Floppie209/Amiga2000-remake/Amiga2000rev6.2.incl.mods.1.8.5.BOM.txt

Partlist from file: Amiga2000rev6.2.incl.mods.1.8.lay6" / 10-11-2019 15:54:42

No	Name	Value			Layer	Comment

1	1				Top	Skull logo
2	201	5mm			Top	Double Ferrite Bead
3	206	100pf			Top	
4	207	100pf			Top	
5	210	100pf			Top	
6	211	100pf			Top	
7	216	5mm			Top	Double Ferrite Bead
8	217	5mm			Top	Double Ferrite Bead
9	218	5mm			Top	Double Ferrite Bead
10	219	5mm			Top	Double Ferrite Bead
11	220	5mm			Top	Double Ferrite Bead
12	221	5mm			Top	Double Ferrite Bead
13	900	5mm			Top	Double Ferrite Bead
14	901	5mm			Top	Double Ferrite Bead
15	902	5mm			Top	Double Ferrite Bead
16	903	5mm			Top	Double Ferrite Bead
17	Hole	3,8 mm			Top	Mounting Hole
18	Hole	3,8 mm			Top	Mounting Hole
19	Hole	3,8 mm			Top	Mounting Hole
20	Hole	3,8 mm			Top	Mounting Hole
21	Hole	3,8 mm			Top	Mounting Hole
22	Hole	3,8 mm			Top	Mounting Hole
23	Hole	3,8 mm			Top	Mounting Hole
24	Hole	3,8 mm			Top	Mounting Hole
25	Hole	3,5 mm			Top	Mounting Hole
26	BT800	3V Battery		Top	Buttoncell Battery
27	C100	0,1uf			Top	
28	C101	0,1uf			Top	
29	C102	0,1uf			Top	
30	C103	0,1uf			Top	
31	C104	0,1uf			Top	
32	C105	0,1uf			Top	
33	C106	0,1uf			Top	
34	C107	0,1uf			Top	
35	C108	0,1uf			Top	
36	C110	0,1uf			Top	
37	C200	0,1uf			Top	
38	C201	0,22uf			Top	
39	C202	0,1uf			Top	
40	C203	0,1uf			Top	
41	C204	0,01uf			Top	
42	C205	0,1uf			Top	
43	C206	0,1uf			Top	
44	C210	0,047uf			Top	
45	C211	0,047uf			Top	
46	C212	0,047uf			Top	
47	C213	0,047uf			Top	
48	C214	470uf 16/25v		Top	
49	C215	0,22uf			Top	
50	C216	0,22uf			Top	
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
449	R402	68R			Top	0805
450	R403	500R			Top	0805
451	R500	4k7			Top	
452	R601	1k			Top	
453	R602	1k			Top	
454	R603	1k			Top	
455	R604	1k			Top	
456	R605	1k			Top	
457	R800	1k			Top	
458	R801	470R			Top	
459	R802	10k			Top	
460	R803	470R			Top	
461	R804	10k			Top	
462	R805	47k			Top	
463	R806	4k7			Top	
464	R807	4k7			Top	
465	R900	1k			Top	
466	R901	Empty			Top	Not Populated
467	R902	4k7			Top	
468	R904	47R			Top	
469	R905	47R			Top	
470	R914	1R 0,5w			Top	0,5 Watt
471	R916	4k7			Top	
472	R917	330R			Top	
473	R1000	330R			Top	
474	R407-C307	68R + 270pf	Top	
475	RP100	4k7			Top	SIP 10
476	RP101	4k7			Top	SIP 10
477	RP102	47R			Top	Isolated Pack 4Res SIP 8
478	RP200	4k7			Top	SIP 10
479	RP201	47R			Top	Isolated Pack 4Res SIP 8
480	RP203	47R			Top	Isolated Pack 4Res SIP 8
481	RP204	68R			Top	Isolated Pack 4Res SIP 8
482	RP205	1k			Top	SIP 6
483	RP300	10k			Top	SIP 10
484	RP301	1k			Top	SIP 6
485	RP500	47R			Top	Isolated Pack 5Res SIP 10
486	RP501	47R			Top	Isolated Pack 5Res SIP 10
487	RP502	22R			Top	Isolated Pack 5Res SIP 10
488	RP503	470R			Top	SIP 10
489	RP600	10k			Top	SIP 8
490	RP601	1K			Top	SIP 10
491	RP602	1K			Top	SIP 10
492	RP603	1K			Top	SIP 10
493	RP604	470R			Top	SIP 10
494	RP605	1K			Top	SIP 10
495	RP607	1k			Top	SIP 6
496	RP700	1K			Top	SIP 10
497	RP701	1K			Top	SIP 10
498	RP702	1K			Top	SIP 10
499	RP703	1K			Top	SIP 10
500	RP704	1K			Top	SIP 10
501	RP705	4k7			Top	SIP 10
502	RP800	1k			Top	SIP 8
503	RP801	4k7			Top	SIP 8
504	RP802	1k			Top	Isolated pack 5res SIP 10
505	RP900	Empty			Top	Not Populated
506	RP901	Empty			Top	Not Populated
507	RP902	47R			Top	Isolated Pack 4Res SIP 8
508	RP903	1k			Top	SIP 6
509	RP904	Empty			Top	Not Pupulated
510	RP905	Empty			Top	Not Populated
511	RP906	Empty			Top	Not Populated
512	RP907	47R			Top	Isolated Pack 4Res SIP 8
513	RP908	1k			Top	SIP 6
514	RP603-1	3k3			Top	SIP 10
515	RP604-1	3k3			Top	SIP 10
516	U100	MC68000			Top	Processor
517	U101	AGNUS 8372		Top	Fat Lady (Agnus)
518	U102	GARY			Top	Gary
519	U103	SN74F245N		Top	
520	U104	SN74LS373N		Top	
521	U105	SN74F245N		Top	
522	U106	SN74LS373N		Top	
523	U107	SN74F04N		Top	
524	U108	SN74LS74AN		Top	
525	U200	PAULA			Top	Paula
526	U201	DENISE			Top	Denise
527	U202	SN74LS157N		Top	
528	U203	SN74LS38N		Top	
529	U204	LF347N/NOPB		Top	
530	U205	SN74LS244N		Top	
531	U206	SN74LS244N		Top	
532	U300	CIA 8520		Top	Odd CIA
533	U301	CIA 8520		Top	Even CIA
534	U302	SN74LS32N		Top	
535	U303	SN74F08N		Top	
536	U304	MC1488N			Top	
537	U305	MC1489N			Top	
538	U500	27C400			Top	Kickstart Chip
539	U501	4256-10			Top	Memory chip
540	U502	4256-10			Top	Memory chip
541	U503	4256-10			Top	Memory chip
542	U504	4256-10			Top	Memory chip
543	U505	4256-10			Top	Memory chip
544	U506	4256-10			Top	Memory chip
545	U507	4256-10			Top	Memory chip
546	U508	4256-10			Top	Memory chip
547	U540	SN74F244N		Top	
548	U541	SN74F244N		Top	
549	U600	SN74LS245N		Top	
550	U601	SN74LS245N		Top	
551	U602	SN74ALS245AN		Top	
552	U603	SN74LS245N		Top	
553	U604	SN74LS245N		Top	
554	U605	SN74ALS245AN		Top	
555	U606	SN74LS32N		Top	
556	U607	SN74LS08N		Top	
557	U800	BUSTER 5721		Top	Buster
558	U801	MSM6242			Top	
559	U802	SN74LS138N		Top	
560	U803	SN74LS08N		Top	
561	U804	SN74LS148N		Top	
562	U805	LM339			Top	
563	U900	SN74F00N		Top	
564	VC800	22-47pF			Top	
565	X1	28.37516MHz Oscillator	Top	Dip14
566	Y800	32768Hz			Top
