Floppie209/Amiga2000-remake/Amiga2000rev6.2.incl.mods.rev-1.8.5-Bestelliste.xlsx

No | Name | Value | Layer | Comment | Mouser | Digikey | Reichelt | Conrad | Ebay | Nr Required
1 | 1 |  | Top | Skull logo | x | x | x | x | x
2 | 201 | 5mm | Top | Double Ferrite Bead | 81-BL03RN2R1P1A |  |  |  |  | 11
3 | 216 | 5mm | Top | Double Ferrite Bead | 81-BL03RN2R1P1A
4 | 217 | 5mm | Top | Double Ferrite Bead | 81-BL03RN2R1P1A
5 | 218 | 5mm | Top | Double Ferrite Bead | 81-BL03RN2R1P1A
6 | 219 | 5mm | Top | Double Ferrite Bead | 81-BL03RN2R1P1A
7 | 220 | 5mm | Top | Double Ferrite Bead | 81-BL03RN2R1P1A
8 | 221 | 5mm | Top | Double Ferrite Bead | 81-BL03RN2R1P1A
9 | 900 | 5mm | Top | Double Ferrite Bead | 81-BL03RN2R1P1A
10 | 901 | 5mm | Top | Double Ferrite Bead | 81-BL03RN2R1P1A
11 | 902 | 5mm | Top | Double Ferrite Bead | 81-BL03RN2R1P1A
12 | 903 | 5mm | Top | Double Ferrite Bead | 81-BL03RN2R1P1A
13 | Hole | 3,8 mm | Top | Mounting Hole | x | x | x | x | x
14 | Hole | 3,8 mm | Top | Mounting Hole | x | x | x | x | x
15 | Hole | 3,8 mm | Top | Mounting Hole | x | x | x | x | x
16 | Hole | 3,8 mm | Top | Mounting Hole | x | x | x | x | x
17 | Hole | 3,8 mm | Top | Mounting Hole | x | x | x | x | x
18 | Hole | 3,8 mm | Top | Mounting Hole | x | x | x | x | x
19 | Hole | 3,8 mm | Top | Mounting Hole | x | x | x | x | x
20 | Hole | 3,8 mm | Top | Mounting Hole | x | x | x | x | x
21 | Hole | 3,5 mm | Top | Mounting Hole | x | x | x | x | x
22 | BT800 | 3V Battery | Top | Buttoncell Battery |  |  |  |  |  | 1
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
225 | C791 | 1000pf | Top |  | 581-SA105C102KAR
226 | C793 | 1000pf | Top |  | 581-SA105C102KAR
227 | C794 | 1000pf | Top |  | 581-SA105C102KAR
228 | C796 | 1000pf | Top |  | 581-SA105C102KAR
229 | C800 | 0,1uf | Top |  | 581-SA105C104KARC
230 | C802 | 0,1uf | Top |  | 581-SA105C104KARC
231 | C803 | 0,1uf | Top |  | 581-SA105C104KARC
232 | C804 | 0,1uf | Top |  | 581-SA105C104KARC
233 | C805 | 0,1uf | Top |  | 581-SA105C104KARC
234 | C810 | 20pf | Top |  | 581-SA102A200JAR |  |  |  |  | 1
235 | C811 | 4,7uf 16v | Top |  | 647-UMA1C4R7MCD2TP
236 | C812 | 0,1uf | Top |  | 581-SA105C104KARC
237 | C813 | 22uf 16v | Top |  | 667-ECA-1CM220B
238 | C814 | 22uf 16v | Top |  | 667-ECA-1CM220B
239 | C815 | 0,1uf | Top |  | 581-SA105C104KARC
240 | C900 | 0,1uf | Top |  | 581-SA105C104KARC
241 | C901 | 0,1uf | Top |  | 581-SA105C104KARC
242 | C902 | Empty | Top | Not Populated | *
243 | C903 | 0,1uf | Top |  | 581-SA105C104KARC
244 | C904 | 100pf | Top |  | 80-C410C101K5G
245 | C905 | 100pf | Top |  | 80-C410C101K5G
246 | C906 | 0,1uf | Top |  | 581-SA105C104KARC
247 | C907 | 100pf | Top |  | 80-C410C101K5G
248 | C908 | 100pf | Top |  | 80-C410C101K5G
249 | C909 | Empty | Top | Not Populated | *
250 | C910 | 0,1uf | Top |  | 581-SA105C104KARC
251 | C912 | 470uf 16/25v | Top |  | 647-UVR1E471MPD
252 | C913 | 47pf | Top |  | 80-C410C470K1G |  |  |  |  | 1
253 | C914 | 100pf | Top |  | 80-C410C101K5G
254 | C915 | 0,1uf | Top |  | 581-SA105C104KARC
255 | C916 | 0,1uf | Top |  | 581-SA105C104KARC
256 | C917 | Empty | Top | Not Populated | *
257 | C918 | 0,1uf | Top |  | 581-SA105C104KARC
258 | C919 | 0,1uf | Top |  | 581-SA105C104KARC
259 | C920 | 100pf | Top |  | 80-C410C101K5G
260 | CN200 | 9pin male | Top | 9 PIN MALE |  |  |  | 625-357-09 |  | 2
261 | CN201 | 9pin male | Top | 9 PIN MALE |  |  |  | 652-357-09
262 | CN202 | 23pin male | Top | 23 PIN MALE |  |  |  |  |  | iComp 1
263 | CN203 | 36pin, (2x18, .100) | Top | INTERNAL VIDEO SLOT TOP | 571-5530843-3 | A31716-ND
264 | CN204 | Audio | Top | Right Audio |  |  | LUM 1553 02 WS |  | ebay | 1
265 | CN205 | Audio | Top | Left Audio |  |  | LUM 1553 02 RT |  | ebay | 1
266 | CN206 | Video B/W | Top | Composite video |  |  | LUM 1553 02 GB |  | ebay | 1
267 | CN207 | 36pin, (2x18, .100) | Top | INTERNAL VIDEO SLOT BOTTOM | 571-5530843-3 | A31716-ND
268 | CN300 | 5pin Din | Top | KEYBOARD |  |  | MABPM 5S | 613-647-14 |  | 1
269 | CN301 | 25pin female | Top | 25 PIN FEMALE |  |  |  | 635-518-05 |  | 1
270 | CN302 | 23pin female | Top | 23 PIN FEMALE |  |  |  |  |  | iComp 1
271 | CN303 | 2x17 | Top | PINHEADER 2X17
272 | CN304 | 2x13 | Top | PINHEADER 2X13
273 | CN305 | 25pin male | Top | 25 PIN MALE |  |  |  | 616-442-12 |  | 1
274 | CN306 | 1x03 | Top | PINHEADER 1X03
 | CN400 | 14pin male | Top | 14 PIN MALE | 538-26-60-4140 |  |  |  |  | 1
275 | CN600 | 86pin (2x43, .100) | Top | CO PROCESSOR SLOT | 571-1-5530843-0 | A144213-ND |  |  |  | 1
276 | CN601 | 100pin, (2x50, .100) | Top | ZORRO II SLOT | 571-5645235-3 | A121376-ND |  |  |  | 5
277 | CN602 | 100pin, (2x50, .100) | Top | ZORRO II SLOT | 571-5645235-3 | A121376-ND
278 | CN603 | 100pin, (2x50, .100) | Top | ZORRO II SLOT | 571-5645235-3 | A121376-ND
279 | CN604 | 100pin, (2x50, .100) | Top | ZORRO II SLOT | 571-5645235-3 | A121376-ND
280 | CN605 | 100pin (2x50, .100) | Top | ZORRO II SLOT | 571-5645235-3 | A121376-ND
281 | CN606 | 1x04 | Top | PINHEADER 1X04
282 | CN700 | 62pin, (2x31, .100) | Top | IBM 8BIT EXPANSION BUS | 571-7-5530843-0 | A121053-ND |  |  |  | 4
283 | CN701 | 62pin, (2x31, .100) | Top | IBM 8BIT EXPANSION BUS | 571-7-5530843-0 | A121053-ND
284 | CN702 | 62pin, (2x31, .100) | Top | IBM 8BIT EXPANSION BUS | 571-7-5530843-0 | A121053-ND
285 | CN703 | 62pin, (2x31, .100) | Top | IBM 8BIT EXPANSION BUS | 571-7-5530843-0 | A121053-ND
286 | CN704 | 36pin, (2x18, .100) | Top | IBM 16BIT EXTENDED BUS | 571-5530843-3 | A31716-ND |  |  |  | 6
287 | CN705 | 36pin, (2x18, .100) | Top | IBM 16BIT EXTENDED BUS | 571-5530843-3 | A31716-ND
288 | CN706 | 36pin, (2x18, .100) | Top | IBM 16BIT EXTENDED BUS | 571-5530843-3 | A31716-ND
289 | CN707 | 36pin, (2x18, .100) | Top | IBM 16BIT EXTENDED BUS | 571-5530843-3 | A31716-ND
290 | D300 | 1N4148 | Top |  | 512-1N4148 |  | 1N 4148 |  |  | 4
291 | D301 | SMD LED Green | Top | 805 | 630-HSMQ-C170-T0000 |  | OSO LGR971 |  |  | 1
292 | D400 | 1N4001 | Top |  | 863-1N4001G |  | 1N 4001 |  |  | 2
293 | D401 | 1N4001 | Top |  | 863-1N4001G
294 | D402 | SMD LED Blue | Top | 805 | 630-HSMR-C170 |  |  |  |  | 1
295 | D403 | SMD LED Red | Top | 805 | 630-HSMH-C170 |  |  |  |  | 1
296 | D800 | 1N4148 | Top |  | 512-1N4148
297 | D801 | 1N4148 | Top |  | 512-1N4148
298 | D803 | 1N4148 | Top |  | 512-1N4148
299 | EMI200 | 100pf | Top |  | 81-DSS1NB32A101Q91A |  |  |  |  | 24
300 | EMI206 | 100pf | Top |  | 81-DSS1NB32A101Q91A
301 | EMI207 | 100pf | Top |  | 81-DSS1NB32A101Q91A
302 | EMI208 | 100pf | Top |  | 81-DSS1NB32A101Q91A
303 | EMI209 | 3300pf | Top |  | 81-DSS1NB32A332Q91A |  |  |  |  | 1
304 | EMI210 | 100pf | Top |  | 81-DSS1NB32A101Q91A
305 | EMI211 | 100pf | Top |  | 81-DSS1NB32A101Q91A
306 | EMI229 | 100pf | Top |  | 81-DSS1NB32A101Q91A
307 | EMI230 | 6800pf | Top |  | 81-DSS1NB32A682Q91A |  |  |  |  | 14
308 | EMI231 | 6800pf | Top |  | 81-DSS1NB32A682Q91A
309 | EMI232 | 6800pf | Top |  | 81-DSS1NB32A682Q91A
310 | EMI233 | 6800pf | Top |  | 81-DSS1NB32A682Q91A
311 | EMI234 | 6800pf | Top |  | 81-DSS1NB32A682Q91A
312 | EMI235 | 6800pf | Top |  | 81-DSS1NB32A682Q91A
313 | EMI236 | 6800pf | Top |  | 81-DSS1NB32A682Q91A
314 | EMI237 | 6800pf | Top |  | 81-DSS1NB32A682Q91A
315 | EMI238 | 6800pf | Top |  | 81-DSS1NB32A682Q91A
316 | EMI239 | 6800pf | Top |  | 81-DSS1NB32A682Q91A
317 | EMI240 | 6800pf | Top |  | 81-DSS1NB32A682Q91A
318 | EMI241 | 6800pf | Top |  | 81-DSS1NB32A682Q91A
319 | EMI242 | 6800pf | Top |  | 81-DSS1NB32A682Q91A
320 | EMI243 | 6800pf | Top |  | 81-DSS1NB32A682Q91A
321 | EMI300 | 330pf | Top |  | 81-DSS1NB32A331Q91A |  |  |  |  | 25
322 | EMI301 | 330pf | Top |  | 81-DSS1NB32A331Q91A
323 | EMI302 | 330pf | Top |  | 81-DSS1NB32A331Q91A
324 | EMI303 | 330pf | Top |  | 81-DSS1NB32A331Q91A
325 | EMI304 | 330pf | Top |  | 81-DSS1NB32A331Q91A
326 | EMI305 | 330pf | Top |  | 81-DSS1NB32A331Q91A
327 | EMI306 | 330pf | Top |  | 81-DSS1NB32A331Q91A
328 | EMI307 | 330pf | Top |  | 81-DSS1NB32A331Q91A
329 | EMI308 | 330pf | Top |  | 81-DSS1NB32A331Q91A
330 | EMI309 | 330pf | Top |  | 81-DSS1NB32A331Q91A
331 | EMI310 | 330pf | Top |  | 81-DSS1NB32A331Q91A
332 | EMI311 | 100pf | Top |  | 81-DSS1NB32A101Q91A
333 | EMI312 | 100pf | Top |  | 81-DSS1NB32A101Q91A
334 | EMI313 | 100pf | Top |  | 81-DSS1NB32A101Q91A
335 | EMI314 | 100pf | Top |  | 81-DSS1NB32A101Q91A
336 | EMI315 | 100pf | Top |  | 81-DSS1NB32A101Q91A
337 | EMI316 | 100pf | Top |  | 81-DSS1NB32A101Q91A
338 | EMI317 | 100pf | Top |  | 81-DSS1NB32A101Q91A
339 | EMI318 | 100pf | Top |  | 81-DSS1NB32A101Q91A
340 | EMI319 | 100pf | Top |  | 81-DSS1NB32A101Q91A
341 | EMI320 | 100pf | Top |  | 81-DSS1NB32A101Q91A
342 | EMI321 | 100pf | Top |  | 81-DSS1NB32A101Q91A
343 | EMI322 | 100pf | Top |  | 81-DSS1NB32A101Q91A
344 | EMI323 | 100pf | Top |  | 81-DSS1NB32A101Q91A
345 | EMI324 | 100pf | Top |  | 81-DSS1NB32A101Q91A
346 | EMI325 | 330pf | Top |  | 81-DSS1NB32A331Q91A
347 | EMI326 | 330pf | Top |  | 81-DSS1NB32A331Q91A
348 | EMI327 | 330pf | Top |  | 81-DSS1NB32A331Q91A
349 | EMI328 | 330pf | Top |  | 81-DSS1NB32A331Q91A
350 | EMI329 | 330pf | Top |  | 81-DSS1NB32A331Q91A
351 | EMI330 | 330pf | Top |  | 81-DSS1NB32A331Q91A
352 | EMI331 | 330pf | Top |  | 81-DSS1NB32A331Q91A
353 | EMI332 | 330pf | Top |  | 81-DSS1NB32A331Q91A
354 | EMI333 | 330pf | Top |  | 81-DSS1NB32A331Q91A
355 | EMI334 | 330pf | Top |  | 81-DSS1NB32A331Q91A
356 | EMI335 | 330pf | Top |  | 81-DSS1NB32A331Q91A
357 | EMI336 | 330pf | Top |  | 81-DSS1NB32A331Q91A
358 | EMI337 | 330pf | Top |  | 81-DSS1NB32A331Q91A
359 | EMI338 | 330pf | Top |  | 81-DSS1NB32A331Q91A
360 | EMI339 | 100pf | Top |  | 81-DSS1NB32A101Q91A
361 | EMI340 | 100pf | Top |  | 81-DSS1NB32A101Q91A
362 | EMI341 | 100pf | Top |  | 81-DSS1NB32A101Q91A
363 | F1 | 4A | Top |  | 576-0251004.MRT1L |  | LITT 0251004.MAT |  |  | 5
364 | F2 | 4A | Top |  | 576-0251004.MRT1L
365 | F3 | 4A | Top |  | 576-0251004.MRT1L
366 | F4 | 4A | Top |  | 576-0251004.MRT1L
367 | F5 | 4A | Top |  | 576-0251004.MRT1L
368 | FB101 | 10mm axial | Top | FERRITE BEAD SMALL | 875-28L0138-10R-10 |  |  |  |  | 8
369 | FB102 | 10mm axial | Top | FERRITE BEAD SMALL | 875-28L0138-10R-10
370 | FB215 | 10mm axial | Top | FERRITE BEAD SMALL | 875-28L0138-10R-10
371 | FB301 | 10mm axial | Top | FERRITE BEAD SMALL | 875-28L0138-10R-10
372 | FB302 | 10mm axial | Top | FERRITE BEAD SMALL | 875-28L0138-10R-10
373 | FB303 | 10mm axial | Top | FERRITE BEAD SMALL | 875-28L0138-10R-10
374 | FB401 | 10mm axial | Top | FERRITE BEAD SMALL | 875-28L0138-10R-10
375 | FB904 | Empty | Top | Not Populated | *
376 | FB906 | Empty | Top | Not Populated | *
377 | FB907 | 10mm axial | Top | FERRITE BEAD SMALL | 875-28L0138-10R-10
378 | Hole | 3,8 mm | Top | Mounting hole | *
379 | Hole | 3,5 mm | Top | Mounting Hole | *
380 | Hole | 3,5 mm | Top | Mounting Hole | *
381 | Hole | 3,5 mm | Top | Release Hole | *
382 | Hole | 3,5 mm | Top | Release Hole | *
383 | Hole | 3,8 mm | Top | Mounting Hole | *
384 | Hole | 3,5 mm | Top | Mounting Hole | *
385 | HY200 | 1x22 female | Top | VIDIOT
386 | J101 | 1x03 | Top | PINHEADER 1X03
387 | J200 | 1x03 | Top | PINHEADER 1X03
388 | J300 | 1x03 | Top | PINHEADER 1X03
389 | J301 | 1x02 | Top | PINHEADER 1X02
390 | J500 | 1x02 | Top | PINHEADER 1X02
391 | J900 | 1x02 | Top | PINHEADER 1X02
392 | PWRCON CN400 | 14pin | Top |  | 538-26-60-4140
393 | Q200 | MPF102 | Top |  |  |  |  |  | ebay: 273089893454 | 2
394 | Q201 | MPF102 | Top |  |  |  |  |  | ebay
395 | Q202 | 2N3906 | Top |  | 833-2N3906-AP |  | 2N 3906 |  |  | 2
396 | Q300 | 2SC945 | Top |  |  |  | SC 945 |  | ebay | 1
397 | Q301 | 2N3904 | Top |  | 833-2N3904-AP |  | 2N 3904 |  |  | 1
398 | Q302 | 2N3906 | Top |  | 833-2N3906-AP
399 | Q400 | PST518B | Top |  |  |  |  |  | ebay: 262529847087 | 1
400 | R1 | 1k | Top |  | 603-CFR-25JR-521K |  |  |  |  | 14
401 | R3 | Empty | Top | Not Populated | *
402 | R101 | 4k7 | Top |  | 603-CFR-25JR-524K7 |  |  |  |  | 11
403 | R104 | 4k7 | Top |  | 603-CFR-25JR-524K7
404 | R105 | 22R | Top |  | 603-CFR-25JR-52-22R |  |  |  |  | 3
405 | R106 | 22R | Top |  | 603-CFR-25JR-52-22R
406 | R109 | 4k7 | Top |  | 603-CFR-25JR-524K7
407 | R110 | 330R | Top |  | 603-CFR-25JT-52-330R |  |  |  |  | 6
408 | R111 | 330R | Top |  | 603-CFR-25JT-52-330R
409 | R114 | 330R | Top |  | 603-CFR-25JT-52-330R
410 | R115 | 330R | Top |  | 603-CFR-25JT-52-330R
411 | R200 | 1R | Top |  | 603-CFR-25JR-52-1R |  |  |  |  | 2
412 | R201 | 4k7 | Top |  | 603-CFR-25JR-524K7
413 | R202 | 10k | Top |  | 603-CFR-25JR-5210K |  |  |  |  | 14
414 | R203 | 10k | Top |  | 603-CFR-25JR-5210K
415 | R204 | 470k | Top |  | 603-CFR-25JR-52470K |  |  |  |  | 2
416 | R205 | 470k | Top |  | 603-CFR-25JR-52470K
417 | R206 | 10k | Top |  | 603-CFR-25JR-5210K
418 | R207 | 10R | Top |  | 603-CFR-25JB-52-10R |  |  |  |  | 2
419 | R208 | 10R | Top |  | 603-CFR-25JB-52-10R
420 | R209 | 1k2 | Top |  | 603-CFR-25JT-52-1K2 |  |  |  |  | 2
421 | R210 | 1k2 | Top |  | 603-CFR-25JT-52-1K2
422 | R211 | 10k | Top |  | 603-CFR-25JR-5210K
423 | R212 | 22R | Top |  | 603-CFR-25JR-52-22R
424 | R213 | 2k7 | Top |  | 603-CFR-25JR-522K7 |  |  |  |  | 1
425 | R214 | 10k | Top |  | 603-CFR-25JR-5210K
426 | R215 | 1R | Top |  | 603-CFR-25JR-52-1R
427 | R216 | 10k | Top |  | 603-CFR-25JR-5210K
428 | R230 | 360R | Top |  | 603-CFR-25JB-52-360R |  |  |  |  | 2
429 | R231 | 10k | Top |  | 603-CFR-25JR-5210K
430 | R232 | 10k | Top |  | 603-CFR-25JR-5210K
431 | R233 | 1k | Top |  | 603-CFR-25JR-521K
432 | R234 | 390R | Top |  | 603-CFR-25JR-52390R |  |  |  |  | 2
433 | R240 | 360R | Top |  | 603-CFR-25JB-52-360R
434 | R241 | 10k | Top |  | 603-CFR-25JR-5210K
435 | R242 | 10k | Top |  | 603-CFR-25JR-5210K
436 | R243 | 1k | Top |  | 603-CFR-25JR-521K
437 | R244 | 390R | Top |  | 603-CFR-25JR-52390R
438 | R300 | 4k7 | Top |  | 603-CFR-25JR-524K7
439 | R301 | 1k | Top |  | 603-CFR-25JR-521K
440 | R302 | 1k | Top |  | 603-CFR-25JR-521K
441 | R305 | 10k | Top |  | 603-CFR-25JR-5210K
442 | R306 | 10k | Top |  | 603-CFR-25JR-5210K
443 | R307 | 68R | Top |  | 603-CFR-25JT-52-68R |  |  |  |  | 2
444 | R308 | 200R | Top |  | 603-CFR-25JR-52-200R |  |  |  |  | 1
445 | R309 | 4k7 | Top |  | 603-CFR-25JR-524K7
446 | R310 | 47R 0,5w | Top | 0,5 Watt | 588-OL4705E-R52 |  |  |  |  | 1
447 | R311 | 1k | Top |  | 603-CFR-25JR-521K
448 | R312 | 1k | Top |  | 603-CFR-25JR-521K
449 | R402 | 68R | Top | 805 | 71-CRCW080568R0JNEA |  |  |  |  | 1
450 | R403 | 500R | Top | 805 | 652-CR0805FX-4990ELF |  |  |  |  | 1
451 | R500 | 4k7 | Top |  | 603-CFR-25JR-524K7
452 | R601 | 1k | Top |  | 603-CFR-25JR-521K
453 | R602 | 1k | Top |  | 603-CFR-25JR-521K
454 | R603 | 1k | Top |  | 603-CFR-25JR-521K
455 | R604 | 1k | Top |  | 603-CFR-25JR-521K
456 | R605 | 1k | Top |  | 603-CFR-25JR-521K
457 | R800 | 1k | Top |  | 603-CFR-25JR-521K
458 | R801 | 470R | Top |  | 603-CFR-25JT-52-470R |  |  |  |  | 2
459 | R802 | 10k | Top |  | 603-CFR-25JR-5210K
460 | R803 | 470R | Top |  | 603-CFR-25JT-52-470R
461 | R804 | 10k | Top |  | 603-CFR-25JR-5210K
462 | R805 | 47k | Top |  | 603-CFR-25JR-5247K |  |  |  |  | 1
463 | R806 | 4k7 | Top |  | 603-CFR-25JR-524K7
464 | R807 | 4k7 | Top |  | 603-CFR-25JR-524K7
465 | R900 | 1k | Top |  | 603-CFR-25JR-521K
466 | R901 | Empty | Top | Not Populated | *
467 | R902 | 4k7 | Top |  | 603-CFR-25JR-524K7
468 | R904 | 47R | Top |  | 603-CFR-25JT-52-47R |  |  |  |  | 2
469 | R905 | 47R | Top |  | 603-CFR-25JT-52-47R
470 | R914 | 1R 0,5w | Top | 0,5 Watt | 603-CFR-50JB-52-1R |  |  |  |  | 1
471 | R916 | 4k7 | Top |  | 603-CFR-25JR-524K7
472 | R917 | 330R | Top |  | 603-CFR-25JT-52-330R
473 | R1000 | 330R | Top |  | 603-CFR-25JT-52-330R
474 | R2 | 68R | Top |  | 603-CFR-25JT-52-68R
475 | RP100 | 4k7 | Top | SIP 10 | 858-L101S472LF |  | SIL 10-9 4,7K |  |  | 4
476 | RP101 | 2k7 | Top | SIP 10 | 858-L101S272LF
477 | RP102 | 47R | Top | Isolated Pack 4Res SIP 8 | 858-L083S470LF |  | SIL 8-4 47 |  |  | 5
478 | RP200 | 4k7 | Top | SIP 10 | 858-L101S472LF
479 | RP201 | 47R | Top | Isolated Pack 4Res SIP 8 | 858-L083S470LF
480 | RP203 | 47R | Top | Isolated Pack 4Res SIP 8 | 858-L083S470LF
481 | RP204 | 68R | Top | Isolated Pack 4Res SIP 8 | 858-L083S680LF |  | SIL 8-4 68 |  |  | 1
482 | RP205 | 1k | Top | SIP 6 | 652-4606M-1LF-1K |  |  |  |  | 5
483 | RP300 | 10k | Top | SIP 10 | 652-4610X-1LF-10K |  | SIL 10-9 10K |  |  | 1
484 | RP301 | 1k | Top | SIP 6 | 652-4606M-1LF-1K |  | SIL 6-5 1,0K
485 | RP500 | 47R | Top | Isolated Pack 5Res SIP 10 | 652-4610X-2LF-47 |  | SIL 10-5 47 |  |  | 2
486 | RP501 | 47R | Top | Isolated Pack 5Res SIP 10 | 652-4610X-2LF-47
487 | RP502 | 22R | Top | Isolated Pack 5Res SIP 10 | 652-4610X-2LF-22 |  | SIL 10-5 22 |  |  | 1
488 | RP503 | 470R | Top | SIP 10 | 652-4610X-1LF-470 |  | SIL 10-9 470 |  |  | 2
489 | RP600 | 10k | Top | SIP 8 | 652-4608X-101-103FLF |  | SIL 8-7 10K |  |  | 1
490 | RP601 | 1K | Top | SIP 10 | 652-4610X-1LF-1K |  | SIL 10-9 1,0K |  |  | 9
491 | RP602 | 1K | Top | SIP 10 | 652-4610X-1LF-1K
492 | RP603 | 1K | Top | SIP 10 | 652-4610X-1LF-1K
493 | RP604 | 470R | Top | SIP 10 | 652-4610X-1LF-470
494 | RP605 | 1K | Top | SIP 10 | 652-4610X-1LF-1K
495 | RP607 | 1k | Top | SIP 6 | 652-4606M-1LF-1K
496 | RP700 | 1K | Top | SIP 10 | 652-4610X-1LF-1K
497 | RP701 | 1K | Top | SIP 10 | 652-4610X-1LF-1K
498 | RP702 | 1K | Top | SIP 10 | 652-4610X-1LF-1K
499 | RP703 | 1K | Top | SIP 10 | 652-4610X-1LF-1K
500 | RP704 | 1K | Top | SIP 10 | 652-4610X-1LF-1K
501 | RP705 | 4k7 | Top | SIP 10 | 858-L101S472LF
502 | RP800 | 1k | Top | SIP 8 | 652-4608X-AP1-102LF |  | SIL 8-7 1,0K |  |  | 1
503 | RP801 | 4k7 | Top | SIP 8 | 652-4608X-AP1-472LF |  | SIL 8-7 4,7K |  |  | 1
504 | RP802 | 1k | Top | Isolated pack 5res SIP 10 | 269-1.0K-RC |  |  |  |  | 1
505 | RP900 | Empty | Top | Not Populated | *
506 | RP901 | Empty | Top | Not Populated | *
507 | RP902 | 47R | Top | Isolated Pack 4Res SIP 8 | 858-L083S470LF
508 | RP903 | 1k | Top | SIP 6 | 652-4606M-1LF-1K
509 | RP904 | Empty | Top | Not Pupulated | *
510 | RP905 | Empty | Top | Not Populated | *
511 | RP906 | Empty | Top | Not Populated | *
512 | RP907 | 47R | Top | Isolated Pack 4Res SIP 8 | 858-L083S470LF
513 | RP908 | 1k | Top | SIP 6 | 652-4606M-1LF-1K
514 | RP603-1 | 3k3 | Top | SIP 10 | 652-4610X-1LF-3.3K |  | SIL 10-9 3,3K |  |  | 2
515 | RP604-1 | 3k3 | Top | SIP 10 | 652-4610X-1LF-3.3K
516 | U100 | MC68000 | Top | Processor |  |  |  |  |  | 1
517 | U101 | AGNUS 8372 | Top | Fat Lady (Agnus) |  |  |  |  |  | 1
518 | U102 | GARY | Top | Gary |  |  |  |  |  | 1
519 | U103 | SN74F245N | Top |  | 595-SN74F245N |  |  |  |  | 2
520 | U104 | SN74LS373N | Top |  | 595-SN74LS373N |  | LS 373 |  |  | 2
521 | U105 | SN74F245N | Top |  | 595-SN74F245N
522 | U106 | SN74LS373N | Top |  | 595-SN74LS373N
523 | U107 | SN74F04N | Top |  | 595-SN74F04N |  |  |  |  | 1
524 | U108 | SN74LS74AN | Top |  | 595-SN74LS74AN |  | SN 74LS74AN TEX |  |  | 1
525 | U200 | PAULA | Top | Paula |  |  |  |  |  | 1
526 | U201 | DENISE | Top | Denise |  |  |  |  |  | 1
527 | U202 | SN74LS157N | Top |  | 595-SN74LS157N |  |  |  |  | 1
528 | U203 | SN74LS38N | Top |  | 595-SN74LS38N |  | LS 38 |  |  | 1
529 | U204 | LF347N/NOPB | Top |  | 926-LF347N/NOPB |  | LF 347 DIL |  |  | 1
530 | U205 | SN74LS244N | Top |  | 595-SN74LS244N |  | SN 74LS244N TEX |  |  | 2
531 | U206 | SN74LS244N | Top |  | 595-SN74LS244N
532 | U300 | CIA 8520 | Top | Odd CIA |  |  |  |  |  | 2
533 | U301 | CIA 8520 | Top | Even CIA
534 | U302 | SN74LS32N | Top |  | 595-SN74LS32N |  | SN 74LS32N TEX |  |  | 2
535 | U303 | SN74F08N | Top |  | 595-SN74F08N |  | SN 74F08N TEX |  |  | 1
536 | U304 | MC1488N | Top |  | 595-MC1488N |  | MC 1488P |  |  | 1
537 | U305 | MC1489N | Top |  | 595-MC1489N |  | MC 1489P |  |  | 1
538 | U500 | 27C400 | Top | Kickstart Chip |  |  |  |  |  | 1
539 | U501 | 4256-10 | Top | Memory chip |  |  |  |  | ebay | 8
540 | U502 | 4256-10 | Top | Memory chip |  |  |  |  | ebay
541 | U503 | 4256-10 | Top | Memory chip |  |  |  |  | ebay
542 | U504 | 4256-10 | Top | Memory chip |  |  |  |  | ebay
543 | U505 | 4256-10 | Top | Memory chip |  |  |  |  | ebay
544 | U506 | 4256-10 | Top | Memory chip |  |  |  |  | ebay
545 | U507 | 4256-10 | Top | Memory chip |  |  |  |  | ebay
546 | U508 | 4256-10 | Top | Memory chip |  |  |  |  | ebay
547 | U540 | SN74F244N | Top |  | 595-SN74F244N |  |  |  |  | 2
548 | U541 | SN74F244N | Top |  | 595-SN74F244N
549 | U600 | SN74LS245N | Top |  | 595-SN74LS245N |  | LS 245 |  |  | 4
550 | U601 | SN74LS245N | Top |  | 595-SN74LS245N
551 | U602 | SN74ALS245AN | Top |  | 595-SN74ALS245AN |  |  |  |  | 2
552 | U603 | SN74LS245N | Top |  | 595-SN74LS245N
553 | U604 | SN74LS245N | Top |  | 595-SN74LS245N
554 | U605 | SN74ALS245AN | Top |  | 595-SN74ALS245AN
555 | U606 | SN74LS32N | Top |  | 595-SN74LS32N
556 | U607 | SN74LS08N | Top |  | 595-SN74LS08N |  | SN 74LS08N TEX |  |  | 2
557 | U800 | BUSTER 5721 | Top | Buster |  |  |  |  |  | 1
558 | U801 | MSM6242 | Top |  |  |  |  |  | ebay | 1
559 | U802 | SN74LS138N | Top |  | 595-SN74LS138N |  | SN 74LS138N TEX |  |  | 1
560 | U803 | SN74LS08N | Top |  | 595-SN74LS08N
561 | U804 | SN74LS148N | Top |  | 595-SN74LS148N |  | LS 148 |  |  | 1
562 | U805 | LM339 | Top |  | 595-LM339N |  |  |  |  | 1
563 | U900 | SN74F00N | Top |  | 595-SN74F00N |  | LM 339 DIL |  |  | 1
564 | VC800 | 22-47pF | Top |  | 659-GKG60015 |  | TSC 06-300 |  | ebay: 223488804146 | 1
565 | X1 | 28.37516MHz Oscillator dip14 | Top |  |  |  |  |  | ebay: 163152656152 | 1
566 | Y800 | 32768Hz | Top |  | 695-CFS-20632768HZFB |  | IQD LFXTAL002995 |  | ebay: 153308385173 | 1
