Floppie209/Amiga2000-remake/(threads)

Thread 1 (2019-05-25):

Infos wanted

rhaamo, 2019-05-25:
hi, contacting you here since I can't find anything else.

Have you taken notes of components values when removing then ?
The only available schematics is https://www.amigawiki.org/dnl/schematics/A2000_R6.pdf and seems to be a 6.0 one and some values are missing (which seems to change between revisions : http://eab.abime.net/showthread.php?t=77864)

If you have made scans before sanding this would be a wonderful thing to easily see where the labels are too !

Any reasons of doing it this way of only a PCB (with a paid software) instead of doing a schematics, then a new PCB layout ? (except doing more work)

Floppie209, 2019-05-30:
Sorry for the answer delay,

To answer your questions. I did take a pictures before sanding the pcb so I know where all the components go and also I made lists of a the components and put the components on the list with tape.
I also noted all the values down and made detailed pictures of the pcb with all the components still in place.

The reason why I do it this way is that I want an exact copy of the board and it is easier to trace the original pcb than to first draw the complete schematic and make a board of that. And the cost for the software is ony 49 euro's. Thats a price I am willing tot pay for software. Eagle will cost me a minimal of 18 euro's a month.

I hope I answered all your questions I just updated the sprint layout file and have begun with the solderside.

rhaamo, 2019-05-30:
hey, thanks !

Yeah for 1:1 replica that seems to be the best way anyway, as I've seen others doing the same with that software.

I'm doing schematics and pcb from scratch personally from a 6.0 schematics scans and my board for some things.

Would you like to share the other pictures and infos you have already done ?
I've found that the internet doesn't seems to have a lot of good (quality) pictures of that amiga, I'm using my rev 6.2 board actually and that's a bit big and uneasy to move around without getting anything damaged.

Floppie209, 2019-05-31:
Yes of course, no problem.

I wil make zip files tomorow and put them on the github page.
Thanks for the reply.

Greetz

Verzonden vanuit Mail<https://go.microsoft.com/fwlink/?LinkId=550986> voor Windows 10

________________________________
Van: Marc Lagrange <notifications@github.com>
Verzonden: Thursday, May 30, 2019 8:51:41 PM
Aan: Floppie209/Amiga2000-remake
CC: Floppie209; Comment
Onderwerp: Re: [Floppie209/Amiga2000-remake] Infos wanted (#1)

hey, thanks !

Yeah for 1:1 replica that seems to be the best way anyway, as I've seen others doing the same with that software.

I'm doing schematics and pcb from scratch personally from a 6.0 schematics scans and my board for some things.

Would you like to share the other pictures and infos you have already done ?
I've found that the internet doesn't seems to have a lot of good (quality) pictures of that amiga, I'm using my rev 6.2 board actually and that's a bit big and uneasy to move around without getting anything damaged.

—
You are receiving this because you commented.
Reply to this email directly, view it on GitHub<https://github.com/Floppie209/Amiga2000-remake/issues/1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>, or mute the thread<https://github.com/notifications/unsubscribe-auth/AL6UAVFSWXQ2U4TY3RXNWPLPYAO33ANCNFSM4HPUTKBQ>.

Floppie209, 2019-05-31:
Marc,

I tried to put the pictures on Github but almost 800 MB is to big even in small parts.
Do you use usenet? As I can post them on usenet if you want. (Thats the easiest way for me)
Or maybe we can try FTP.
If you have another solution I would certenly like to know.

Greetz

Jeroen
Verzonden vanuit Mail<https://go.microsoft.com/fwlink/?LinkId=550986> voor Windows 10

________________________________
Van: Marc Lagrange <notifications@github.com>
Verzonden: Thursday, May 30, 2019 8:51:41 PM
Aan: Floppie209/Amiga2000-remake
CC: Floppie209; Comment
Onderwerp: Re: [Floppie209/Amiga2000-remake] Infos wanted (#1)

hey, thanks !

Yeah for 1:1 replica that seems to be the best way anyway, as I've seen others doing the same with that software.

I'm doing schematics and pcb from scratch personally from a 6.0 schematics scans and my board for some things.

Would you like to share the other pictures and infos you have already done ?
I've found that the internet doesn't seems to have a lot of good (quality) pictures of that amiga, I'm using my rev 6.2 board actually and that's a bit big and uneasy to move around without getting anything damaged.

—
You are receiving this because you commented.
Reply to this email directly, view it on GitHub<https://github.com/Floppie209/Amiga2000-remake/issues/1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>, or mute the thread<https://github.com/notifications/unsubscribe-auth/AL6UAVFSWXQ2U4TY3RXNWPLPYAO33ANCNFSM4HPUTKBQ>.

rhaamo, 2019-05-31:
Yes I can share you an upload link, can you send me an email (on my profile) ?

Floppie209, 2019-05-31:
Is the dashie@sigpipe.me<mailto:dashie@sigpipe.me> the emailadres of your profile?

Verzonden vanuit Mail<https://go.microsoft.com/fwlink/?LinkId=550986> voor Windows 10

________________________________
Van: Marc Lagrange <notifications@github.com>
Verzonden: Friday, May 31, 2019 10:04:45 AM
Aan: Floppie209/Amiga2000-remake
CC: Floppie209; Comment
Onderwerp: Re: [Floppie209/Amiga2000-remake] Infos wanted (#1)

Yes I can share you an upload link, can you send me an email (on my profile) ?

—
You are receiving this because you commented.
Reply to this email directly, view it on GitHub<https://github.com/Floppie209/Amiga2000-remake/issues/1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>, or mute the thread<https://github.com/notifications/unsubscribe-auth/AL6UAVCPG3HEIVIQXYYH2FDPYDLZ3ANCNFSM4HPUTKBQ>.

rhaamo, 2019-05-31:
yes

Floppie209, 2019-05-31:
They are on the way.
I hope they can help you.

By the way there is a german guy named gonzo who has already made the schematics and a pcb of the amiga2000 rev 6.2 in Eagle.
He promised me the files but until now he send me nothing.

Greetz

Jeroen

Verzonden vanuit Mail<https://go.microsoft.com/fwlink/?LinkId=550986> voor Windows 10

________________________________
Van: Marc Lagrange <notifications@github.com>
Verzonden: Friday, May 31, 2019 12:19:44 PM
Aan: Floppie209/Amiga2000-remake
CC: Floppie209; Comment
Onderwerp: Re: [Floppie209/Amiga2000-remake] Infos wanted (#1)

yes

—
You are receiving this because you commented.
Reply to this email directly, view it on GitHub<https://github.com/Floppie209/Amiga2000-remake/issues/1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>, or mute the thread<https://github.com/notifications/unsubscribe-auth/AL6UAVFAD6B7KDLX6UHSPO3PYD3UBANCNFSM4HPUTKBQ>.

rhaamo, 2019-05-31:
Thanks !

Are the PCB faults issues when desoldering or it might be factory done ? (I can compare with my 6.2 one)

Might be one from the a1k forum, but no publicly available stuff..

I'm doing it with KiCAD here, eagle is 100E/month for a PCB this size unfortunately.

Floppie209, 2019-05-31:
The faults are from desoldering. Its an old board and sometimes a little piece lets go.
And yes he is from the a1k forum. He promised to mail me the eagle files but until now nothing. He told me not to redistribute them because of license issues.
When youre done with Kicad I can check your files as well as two people see more than one. Yust let me know. You have my email.

Hope you can use the photo’s

Greetz

Jeroen

Verzonden vanuit Mail<https://go.microsoft.com/fwlink/?LinkId=550986> voor Windows 10

________________________________
Van: Marc Lagrange <notifications@github.com>
Verzonden: Friday, May 31, 2019 1:18:02 PM
Aan: Floppie209/Amiga2000-remake
CC: Floppie209; Comment
Onderwerp: Re: [Floppie209/Amiga2000-remake] Infos wanted (#1)

Thanks !

Are the PCB faults issues when desoldering or it might be factory done ? (I can compare with my 6.2 one)

Might be one from the a1k forum, but no publicly available stuff..

I'm doing it with KiCAD here, eagle is 100E/month for a PCB this size unfortunately.

—
You are receiving this because you commented.
Reply to this email directly, view it on GitHub<https://github.com/Floppie209/Amiga2000-remake/issues/1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>, or mute the thread<https://github.com/notifications/unsubscribe-auth/AL6UAVGOLEPW5KTTEZC4VPTPYECOVANCNFSM4HPUTKBQ>.

Closed 2019-06-27.

Thread 3 (2021-03-03):

R215 & R3

Casca2525, 2021-03-03:
for r215 there is just a pad and no hole,  also R3 is not listed in the BOM nor the component locator, nor is it mentioned in the readme.md does R3 get populated? if so what is the value?

rgbwalker, 2021-04-14:
Hi!

I started to solder components on a PCB "Amiga 2000 Remake Rev 1.8.5" and have the same doubt...

The R3 value for the PCB version 1.8.5 is on the following file:
https://github.com/Floppie209/Amiga2000-remake/blob/master/Amiga2000rev6.2.incl.mods.rev-1.8.5-Bestelliste.xlsx
Appears on Excel file: row401 as "R3 empty" and "Not populated", and the value for R215 as "1R".

As both resistors shares a node, (if the R3 are "Not populated"), ok, we can forget this, but R215 have an square node without hole, this is the correct place as ths silkscreen shows?

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

Finally:
R3: unpopulated
R215: as the silkscreen

It si correct?

Thank in advance!!!

Casca2525, 2021-04-27:
on a Commodore rev 6 board its poked in to a via but on floppy209's board his vias are smaller and the resistor lead will not fit I plan to crazy glue the resistor to fix it in place then solder the lead to the pad

Regards Mike VPCC

On Wednesday, April 14, 2021, 07:50:02 a.m. EDT, rgbwalker ***@***.***> wrote:

Hi!

I started to solder components on a PCB "Amiga 2000 Remake Rev 1.8.5" and have the same doubt...

The R3 value for the PCB version 1.8.5 is on the following file:
https://github.com/Floppie209/Amiga2000-remake/blob/master/Amiga2000rev6.2.incl.mods.rev-1.8.5-Bestelliste.xlsx
Appears on Excel file: row401 as "R3 empty" and "Not populated", and the value for R215 as "1R".

As both resistors shares a node, (if the R3 are "Not populated"), ok, we can forget this, but R215 have an square node without hole, this is the correct place as ths silkscreen shows?

Finally:
R3: unpopulated
R215: as the silkscreen

It si correct?

Thank in advance!!!

—
You are receiving this because you authored the thread.
Reply to this email directly, view it on GitHub, or unsubscribe.

rgbwalker, 2021-05-03:
Hi Casca2525.

You mean to solder R215 as silkscreen shows, thats right? with a R215 terminal solder on square pad? And ignore R3 (R3 Not populated as Excel file shows).

Thanks!

Casca2525, 2021-05-03:
thats what I was planning to try, never heard back from the designer

Regards Mike VPCC

On Monday, May 3, 2021, 06:07:21 a.m. EDT, rgbwalker ***@***.***> wrote:

Hi Casca2525.

You mean to solder R215 as silkscreen shows, thats right? with a R215 terminal solder on square pad? And ignore R3 (R3 Not populated as Excel file shows).

Thanks!

—
You are receiving this because you authored the thread.
Reply to this email directly, view it on GitHub, or unsubscribe.

rhaamo, 2021-05-04:
From original PCBs, R215 isn't following the silkscreen (https://wiki.sigpipe.me/amiga:a2000:rev6.2fixes):
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

As for R3, I didn't saw it in my original 6.2 rev, nor the schematics.

rgbwalker, 2021-05-13:
Thanks rhaamo!

The new board seems like a board with mod integrated.
This is the new board:
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
And this is my damaged old board Rev 6 (PCB ASSY312720):
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
- Both have the resistor R215, OK. I will solder!!!
- R3 is unpopulated, (on the xcel file appears unpopulated), and on the locator  http://locator.reamiga.info/locator.php?project=A2000  from John Hertell dont R3 appear on the list. I will let unpopulated.

Thanks to all for the explanations!!!

Casca2525, 2021-05-13:
Wow so many variations, my 3 rev6 have r215 going on an angle over to the via between EMI301 and EMI 310
Regards Mike VPCC

    On Thursday, May 13, 2021, 11:36:24 a.m. EDT, rgbwalker ***@***.***> wrote:

Thanks rhaamo!

The new board seems like a board with mod integrated.
This is the new board:

And this is my damaged old board Rev 6 (PCB ASSY312720):

   - Both have the resistor R215, OK. I will solder!!!
   - R3 is unpopulated, (on the xcel file appears unpopulated), and on the locator http://locator.reamiga.info/locator.php?project=A2000 from John Hertell dont R3 appear on the list. I will let unpopulated.

Thanks to all for the explanations!!!

—
You are receiving this because you authored the thread.
Reply to this email directly, view it on GitHub, or unsubscribe.

Thread 4 (2021-04-14):

C1_and _R2

rgbwalker, 2021-04-14:
Hi!

On a pcb "Amiga 2000 Remake Rev 1.8.5", while I solder the passive components I have a doubt about C1 and R2 as picture shows:
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
It is sharing node with FB906, (as the main file show FB906 is unpopulated, ok), but the C1 and R2 must to be soldered as a serial? As show the silkscreen?

C1 and R2 sharing a soldered terminal "on air"?

What value for the R2? 68 Ohm?

Thanks in advance!!!

PeteDWard, 2021-04-25:
Hi,

Not started my build yet but either side/node of FB906 are ground and doing a continuity test confirms that.

As for R2 and C1, after some investigating on Google etc these should be connected inline as per the silk screen. There is a blog post that you may find useful https://wordpress.hertell.nu/?p=1029 btw.

Hope this helps

rgbwalker, 2021-04-27:
Thanks for the help!

Ok, no doubt about FB906, (on the Github project main file is explained, FB906 is unpopulated), And as you say, on the wonderful John Hertell´s web: https://wordpress.hertell.nu/?p=1029 are some pics, and is posssible to show something about this components.  But the PCB used by John Hertell this time is Rev 1.6 and my PCB version is 1.8.5. Here is may doubt, is the same on both version?

I supose is the same, but im not sure.

I found this interesting web: https://retrohax.net/amiga-2000-codename-tesseract/ with an article about the same PCB version (Rev 1.8.5), it is possible to show some pics, with this components, with the R3 between R215 doubts too.

Thanks for your answer!

rhaamo, 2021-05-04:
The mod is for the 6.2 original rev, the PCB version of this repo don't mind. and effectively they are soldered "in the air", 270pF and 68ohm from CPU E line to GND, FB906 is left unpopulated.
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

rgbwalker, 2021-05-13:
Hi rhaamo again!

No doubt! I will solder C1 and R2 as silkscreen shows with a common leg on the air.

Thanks!!!

Thread 5 (2021-08-03):

+5 volt shorting to ground

PeteDWard, 2021-08-03:
Hi All,

This may be a stupid question but would welcome your take.

Since getting all the capacitors on the board, the other components were already in place, I am now seeing a short between the +5 volts and the ground when doing a continuity test.

Is this normal when only the passives are in place, _none_ of the IC's are installed yet. I only noticed it since installing C214, C226 and C913 (all three are by the VIDOT/HY200). I have check for any obvious issues such as polarity on the Capacitors but they look fine visually.

Had a look at a 500+ board and this does the same _but only for a second_.

Would welcome any guidance here.

Acill, 2021-08-03:
Ive never noticed that. Its possible some other component prevents that
like a diode or a load on the IC's when installed, but I am not sure. I can
only test with the boards I get produced and that wouldnt help you much if
it was different and yours was made from another manufacturer.

Paul

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

PeteDWard, 2021-08-03:
Hi Acill,

Thank you for replying so quickly.

All the diodes are in place, just checked their polarity and they all look okay.

Only have the crystal (X1) and R2/C1 to fit. I suspect this may be down to an IC, as you suggest, which aren't in place yet so will fit these and run another continuity test.

The board was from Bob's bits on Tindie, and is 1.8.5 and looks identical to the component locator.

Many thanks

Thread 6 (2022-03-24):

A500-2Meg-Chip-ram

bit-image, 2022-03-24:
I built 2 A2000 remake boards, both work great. However, when I installed the A500-2Meg-Chip-ram board, I get a black screen completely dead. Is the remake board incompatible with these megachip mods?

https://github.com/LIV2/A500-2Meg-Chip-ram

XR4x4, 2022-04-09:
I am using the exact same 2meg chip adaptor you linked and have no issues on my board.

bit-image, 2022-04-09:
Hey, thanks for reaching out, that is good to know. I was not able to determine if I have a bad adapter board or a faulty 8375. For now I have just resoldered the plcc socket back in and am sticking with a 8372a. Someday I will attempt this again.

-Jeremy

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

DoctorDan1986, 2022-04-24:
> Hey, thanks for reaching out, that is good to know. I was not able to determine if I have a bad adapter board or a faulty 8375. For now I have just resoldered the plcc socket back in and am sticking with a 8372a. Someday I will attempt this again.
> […](#)

If you'd be interested in passing on that 8375, I'd love to take it off your hands.

isaaclepes, 2022-05-29:
It might be related to the rev 6.4 change for support on the 8375, did you change R101?

Rev. 6.4 (Replace old Agnus with 8375, instead of resistor R101: Capacitor (100nF) from the right side of R101 to ground)

Thread 7 (2022-05-03):

Zorro Instability

bit-image, 2022-05-03:
I have built 3 of these boards, 2 work perfectly. However, a third board seems to have issues with zorro slots, specifically I am testing with a known good A2052 and with my fist buster chip, all but the slot 1 pass the Amiga Test Kit memory test. With another Buster chip, every slot fails the Amiga Test Kit memory test. However, both buster chips work great in my other amiga boards. Anything I can check to get this working? Thanks

bit-image, 2022-05-04:
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

bit-image, 2022-05-05:
Troubleshooting further, seems like this could be a noise related issue. When I ground the stock amiga power supply to the motherboard, the screen noise is greatly reduced and the memory tested passes on all but the first zorro slot. My first 2 builds where using the black/copper board and this latest build with issues is the green/tin based Remake board. Both the black and green boards are rev 1.8.5. Is the green board somehow less tolerant of noise?

rhaamo, 2022-05-05:
soldermask color shouldn't have an impact on the ground plane and pins, are both black and green coming from the same gerbers ?

if only the first zorro slot has issues, tries looking if there is no issues with the traces on the PCB, that would be the main culprit especially the GND pins.

bit-image, 2022-05-09:
After mounting the board in a A2000 case, I get some different behavior, SLOT 1 is working well now, however the other slots dont even detect the ram card. I toned out all of the connections and find no issues. This is very hard to pinpoint, any other suggestions  on how to get the other four slots to recognize the ram card? Thanks

bit-image, 2022-05-10:
So I think I may have figured out the issue, the problem went away when I installed the bottom shield. It would seem that my issues are the result of noise / feedback ?

Thread 8 (2023-01-23):

448	R401	1k			Top	- Where is it???

KaosLord, 2023-01-23:
The locator seem to have skipped this one and I'm presently going blind and a bit crazy trying to find it... Can somebody give me a clue where it is?

rhaamo, 2023-01-24:
Where is this R401 located ? And which board revision ?

I can't locate it in either schematics, my own repro schematics or one available BOM.

KaosLord, 2023-01-24:
Amiga2000rev6.2.incl.mods.1.8.5.BOM.txt

448	R401	1k			Top

Line 452 in the text file. I'm building the pcb I got  from: https://www.tindie.com/products/bobsbits/amiga-2000-replica-pcb-by-floppie209/

I'm unable to locate that part and it's absent from the locator.

rhaamo, 2023-01-24:
Probably a typo leftover from an older revision, that resistor isn't mentionned in the xlsx sheet, nor https://docs.google.com/spreadsheets/d/15iEQ0hM72iEbbcy1ZybIc3_K2UyTCFhJ_Zc4mvceAfE/edit

KaosLord, 2023-01-24:
Thanks!

Closed 2023-01-24.
