Floppie209/Amiga2000-remake/(list of files, drawings)

Other design files:
Amiga2000rev6.2.incl.mods.1.7.lay6
